Electrodude-AI/UGVC_Electronics/Assets/3D Models/USB-3.0.step

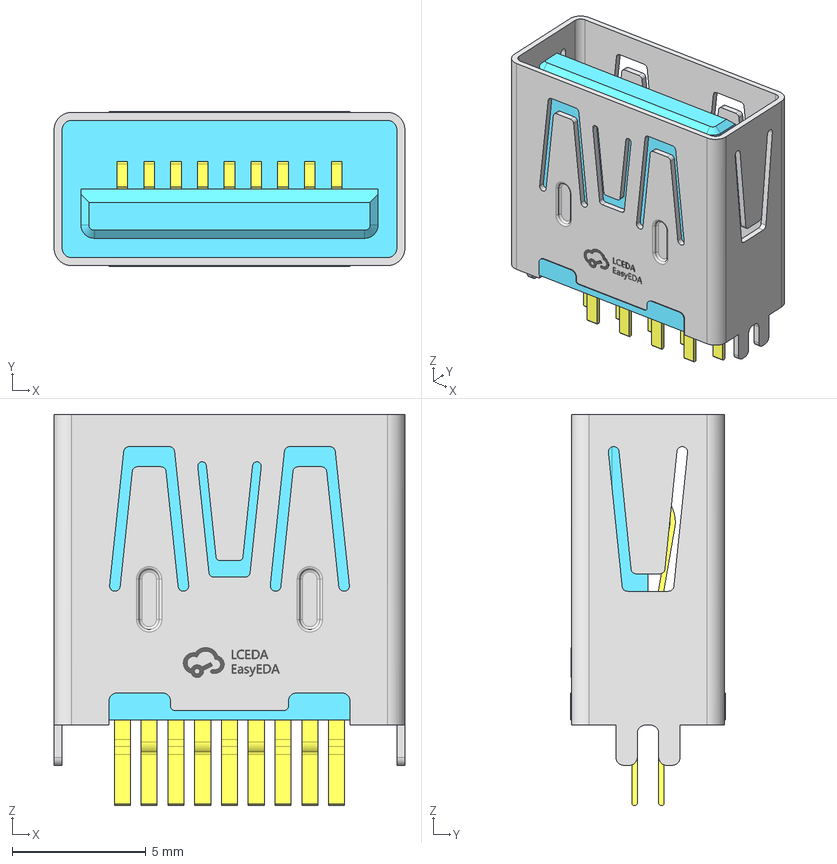
[picture p1: CAD file, 2026-05-20]
Assets/3D Models/USB-3.0.step
13.1 x 5.80 x 14.6 mm
