Electrodude-AI/UGVC_Electronics/Assets/3D Models/XT30PW-M.step

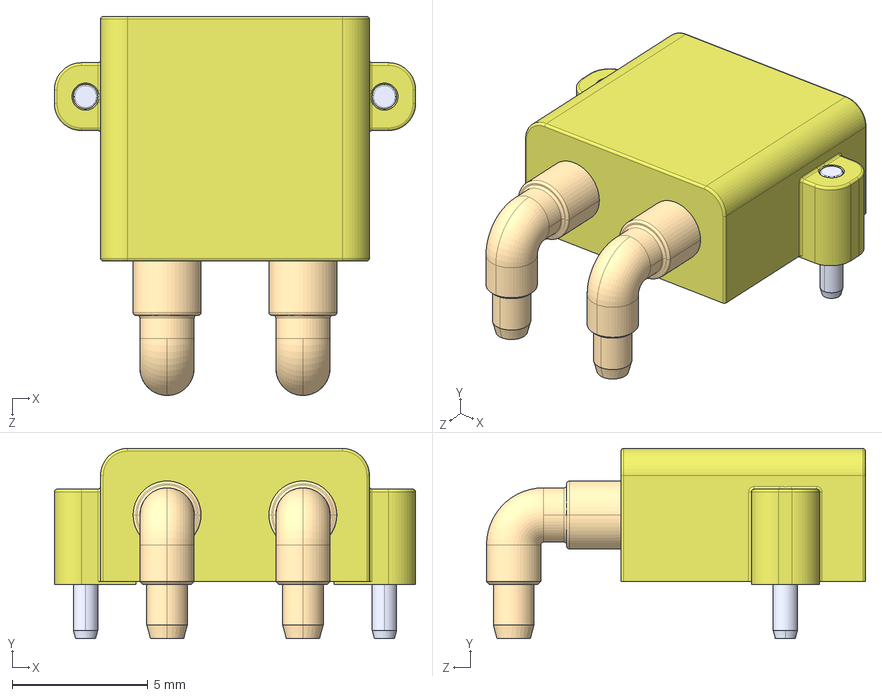
[picture p2: CAD file, 2026-05-20]
Assets/3D Models/XT30PW-M.step
13.3 x 7.00 x 14.0 mm
