Electrodude-AI/UGVC_Electronics/(commit log)

2026-05-05 PCB Done
    [UGV.kicad_pcb]
2026-05-20 Changed the footprint
    [UGV.kicad_pcb, UGV.kicad_sch, USB-3.0.step, XT30PW-M.step]
2026-05-22 Final PCB
    [UGV-B_Cu.gbr, UGV-B_Mask.gbr, UGV-B_Paste.gbr, UGV-B_Silkscreen.gbr, UGV-Edge_Cuts.gbr, UGV-F_Cu.gbr, UGV-F_Mask.gbr, UGV-F_Paste.gbr]
2026-06-05 initialized electronics repo
    [UGV-B_Cu.gbr, UGV-B_Mask.gbr, UGV-B_Paste.gbr, UGV-B_Silkscreen.gbr, UGV-Edge_Cuts.gbr, UGV-F_Cu.gbr, UGV-F_Mask.gbr, UGV-F_Paste.gbr]
